ptrichr/CISESS-2024/(commit log)

2024-06-12 first prototype, roughly based off arduino iteration
2024-06-12 didn't track the src folder for some reason?
    [adc_toplevel.v, radiometer_toplevel.v, switch_clock_divider.v]
2024-06-12 sources were copied into project not directly being changed, fixed
    [adc_toplevel.v, radiometer_toplevel.v, switch_clock_divider.v]
2024-06-19 using FSM structure for ADC module now
2024-06-20 added adc clk divide i think
2024-07-11 finished UART module
2024-07-12 added arduino test file, will test ADC shortly
    [adc_toplevel.v, const1.xdc, radiometer_toplevel.v, switch_clock_divider.v]
2024-07-16 comments and rework ADC logic to have higher data resolution
    [adc_toplevel.v]
2024-07-23 changed UART implementation
